webtrackerxy/MiniDroneGimbal/v1.2/top_pivot_section_v1.2.png

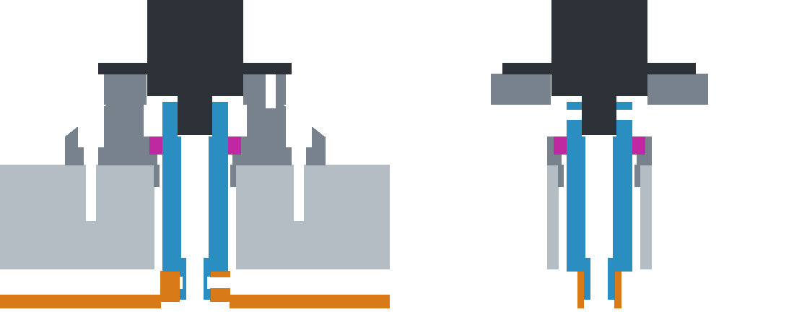
v1.2/top_pivot_section_v1.2.png
