webtrackerxy/MiniDroneGimbal/v1.2/BOM_v1.2.md

# Mini Drone Gimbal v1.2: bill of materials

Generated by `mini_drone_gimbal.py`. Print files are in `stl/` and `3mf/`.

## Printed parts

| File | Qty | Size, mm | Solid mass | Notes |
|---|---|---|---|---|
| upright_v1.2 | 2 | 232 × 24 × 24 | 326 g | Frame sides |
| top_bar_a_v1.2 | 1 | 203 × 24 × 24 | 121 g | Top bar, with the top pivot |
| top_bar_b_v1.2 | 1 | 119 × 24 × 24 | 70 g | Top bar |
| outer_ring_v1.2 | 1 | 226 × 215 × 10 | 30 g | Yaw ring |
| inner_ring_v1.2 | 1 | 220 × 188 × 10 | 27 g | Pitch ring |
| cradle_v1.2 | 1 | 52 × 182 × 28 | 14 g | Roll axis, holds the drone |
| sensor_mount_v1.2 | 1 | 28 × 49 × 13 | 6 g | Sensor board plate under the tray |
| cover_v1.2 | 1 | 46 × 60 × 18 | 5 g | Holds the drone body down |
| clip_v1.2 | 1 | 78 × 67 × 10 | 8 g | Snaps the cover on |
| bearing_fit_test_v1.2 | 1 | 51 × 8 × 10 | 1 g | Print first, to tune BEARING_D |
| pivot_shims_v1.2 | 1 | 53 × 4 × 1 | 0 g | 8 on one plate, 6 needed. Use a brim |
| slip_mount_v1.2 | 1 | 60 × 50 × 26 | 28 g | Holds the slip ring on the top bar |
| slip_tube_v1.2 | 1 | 15 × 15 × 46 | 7 g | Turns with the outer ring, carries the slip ring stem |
| base_a_v1.2 | 1 | 217 × 217 × 54 | 403 g | Base frame, corner section |
| base_b_v1.2 | 1 | 105 × 217 × 24 | 195 g | Base frame, corner section |
| base_c_v1.2 | 1 | 217 × 105 × 54 | 251 g | Base frame, corner section |
| base_d_v1.2 | 1 | 105 × 105 × 24 | 115 g | Base frame, corner section |

Total solid mass 1.61 kg. That is the upper limit: with 15% infill on the frame it prints much lighter. PLA or PETG, 0.2 mm layers, no supports.

## Hardware

| Part | Qty | Used for |
|---|---|---|
| MR63ZZ bearing, 3 × 6 × 2.5 mm | 5 | Two per pivot, none at the top pivot |
| M3 × 8 socket head screw | 8 | 5 pivot axles, 3 slip ring flange |
| M3 × 12 socket head screw | 4 | Uprights to base and top bar |
| M3 × 16 socket head screw | 4 | 2 sensor mount to tray, 2 slip mount to top bar |
| M3 × 20 socket head screw | 12 | Frame lap joints |
| M3 hex nut, 5.5 mm across flats | 19 | 5 pivots, 12 frame joints, 2 sensor mount |
| M3 × 5 socket head screw | 1 | Side screw, outer ring boss to slip tube |
| M3 × 6 set screw, or short M3 screw | 2 | Slip tube onto the slip ring stem |
| M3 washer, 7 mm OD | 3 | Under the slip ring flange screws |
| Slip ring, 12 wire, 22 mm body (SNM022A-12) | 1 | Top pivot, and power to the drone |
| 6702ZZ ball bearing, 15 × 21 × 4 mm | 1 | Steadies the slip tube inside slip_mount |
| M3 screw or 3 mm woodscrew, 30 mm or longer | 4 | Base to the bench |
| Soft foam pad, about 15 × 20 × 2–3 mm | 1 | Inside the crown of the cover |
