webtrackerxy/MiniDroneGimbal/v1.2/3mf/outer_ring_v1.2.3mf

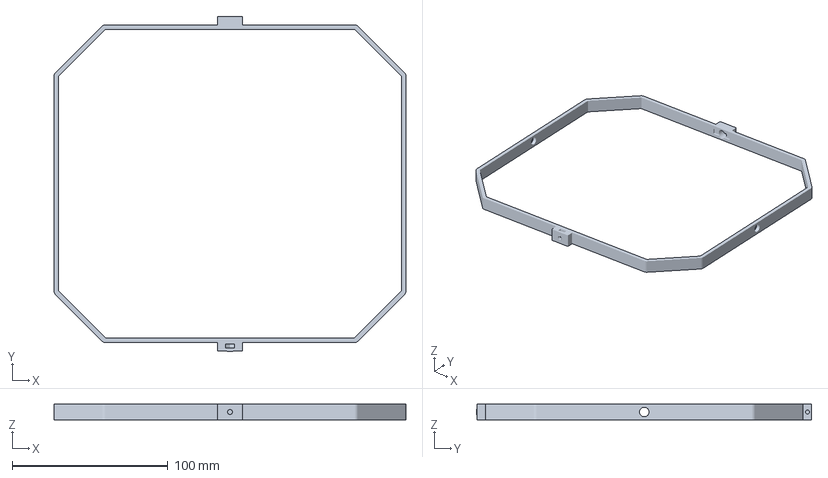
[picture p3: CAD file, 2026-11-06]
v1.2/3mf/outer_ring_v1.2.3mf
226.0 x 215.4 x 10.0 mm
