webtrackerxy/MiniDroneGimbal/v1.2/3mf/top_bar_b_v1.2.3mf

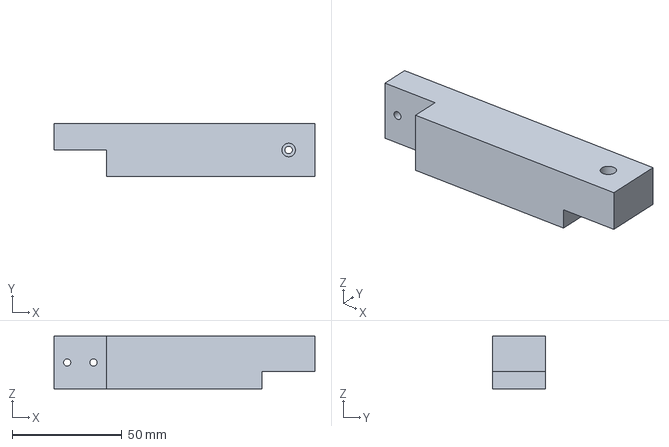
[picture p4: CAD file, 2026-11-06]
v1.2/3mf/top_bar_b_v1.2.3mf
119.0 x 24.0 x 24.0 mm
