webtrackerxy/MiniDroneGimbal/v1.2/3mf/base_c_v1.2.3mf

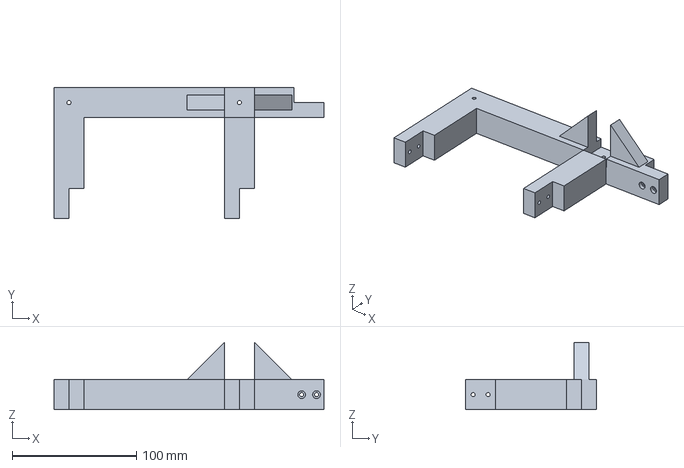
[picture p5: CAD file, 2026-11-06]
v1.2/3mf/base_c_v1.2.3mf
217.0 x 105.0 x 54.0 mm
