webtrackerxy/MiniDroneGimbal/v1.2/3mf/slip_tube_v1.2.3mf

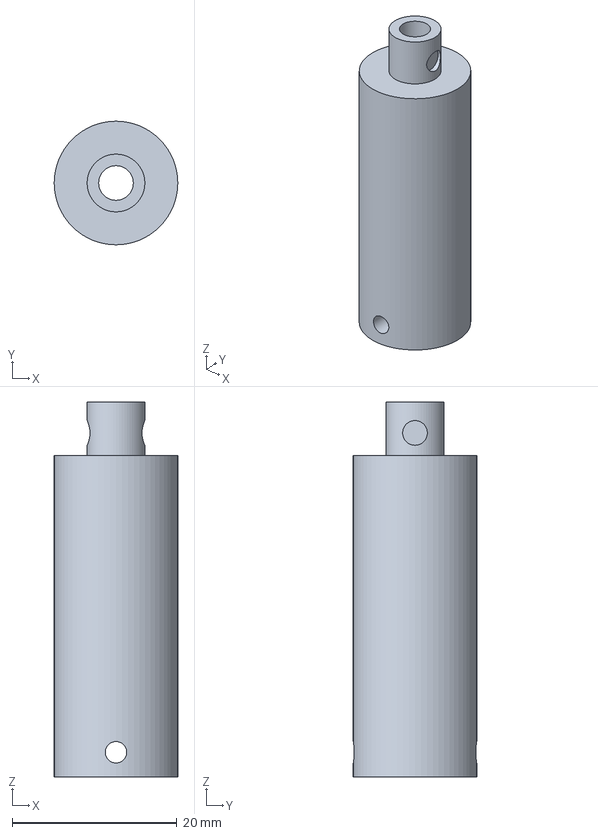
[picture p6: CAD file, 2026-11-06]
v1.2/3mf/slip_tube_v1.2.3mf
15.0 x 15.0 x 45.5 mm
