webtrackerxy/MiniDroneGimbal/v1.2/3mf/pivot_shims_v1.2.3mf

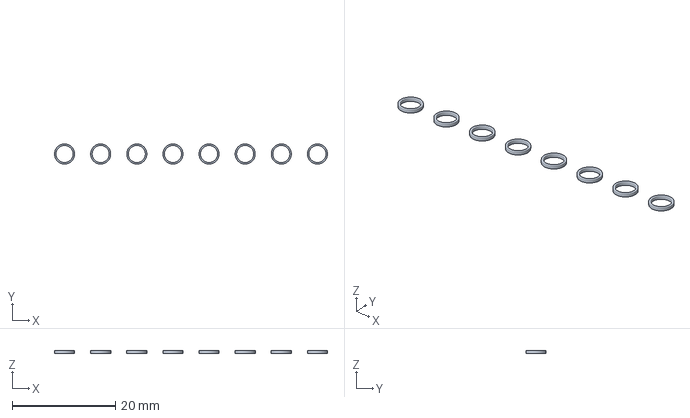
[picture p7: CAD file, 2026-11-06]
v1.2/3mf/pivot_shims_v1.2.3mf
52.9 x 3.90 x 0.6 mm
