webtrackerxy/MiniDroneGimbal/v1.2/3mf/slip_mount_v1.2.3mf

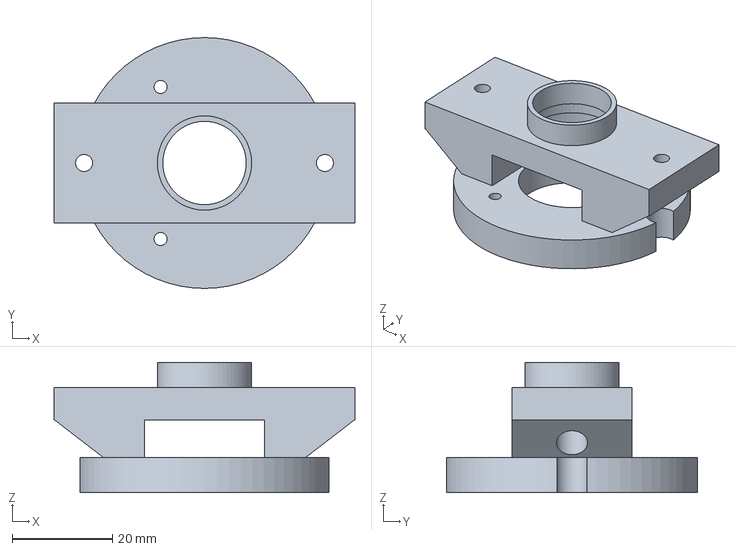
[picture p8: CAD file, 2026-11-06]
v1.2/3mf/slip_mount_v1.2.3mf
60.0 x 50.0 x 26.0 mm
