webtrackerxy/MiniDroneGimbal/v1.2/3mf/sensor_mount_v1.2.3mf

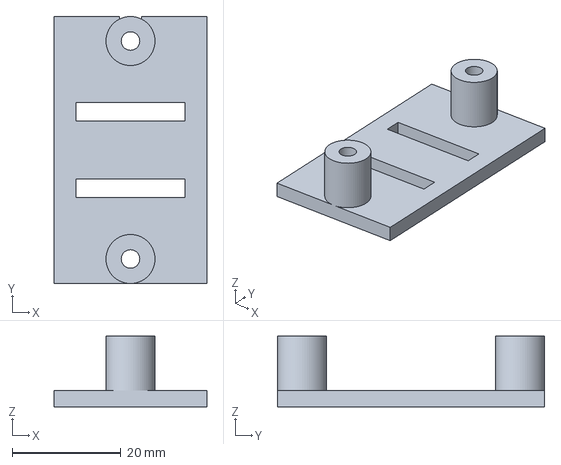
[picture p9: CAD file, 2026-11-06]
v1.2/3mf/sensor_mount_v1.2.3mf
28.0 x 49.0 x 13.0 mm
