webtrackerxy/MiniDroneGimbal/v1.2/3mf/cover_v1.2.3mf

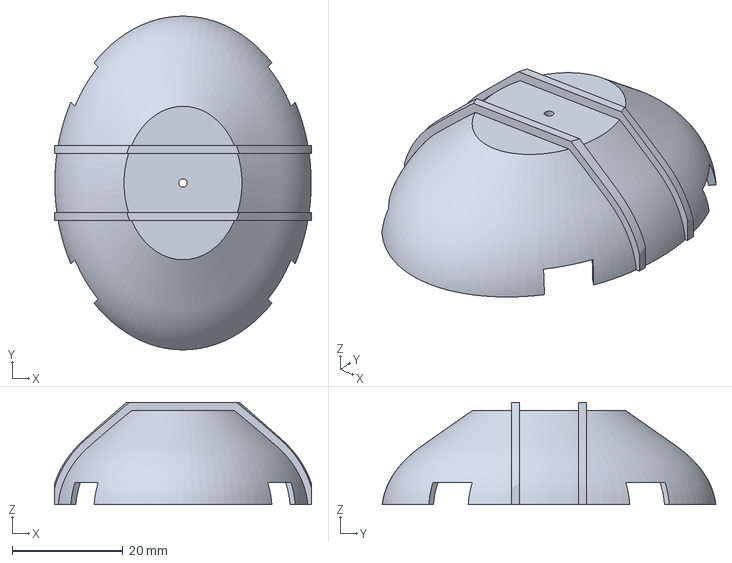
[picture p10: CAD file, 2026-11-06]
v1.2/3mf/cover_v1.2.3mf
46.4 x 60.3 x 18.5 mm
