webtrackerxy/MiniDroneGimbal/v1.2/3mf/cradle_v1.2.3mf

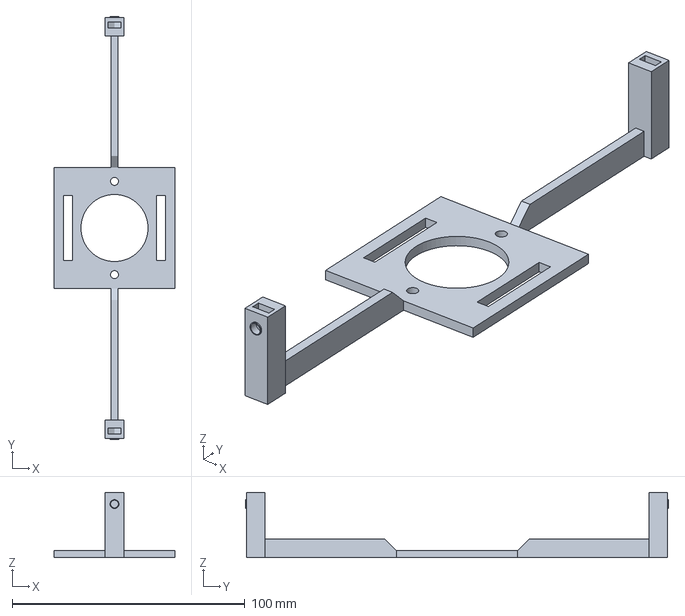
[picture p11: CAD file, 2026-11-06]
v1.2/3mf/cradle_v1.2.3mf
52.0 x 181.8 x 28.0 mm
