webtrackerxy/MiniDroneGimbal/v1.2/3mf/base_a_v1.2.3mf

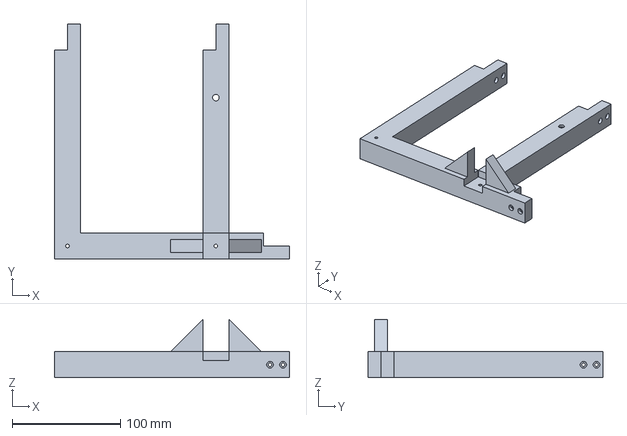
[picture p12: CAD file, 2026-11-06]
v1.2/3mf/base_a_v1.2.3mf
217.0 x 217.0 x 54.0 mm
