webtrackerxy/MiniDroneGimbal/v1.2/3mf/base_d_v1.2.3mf

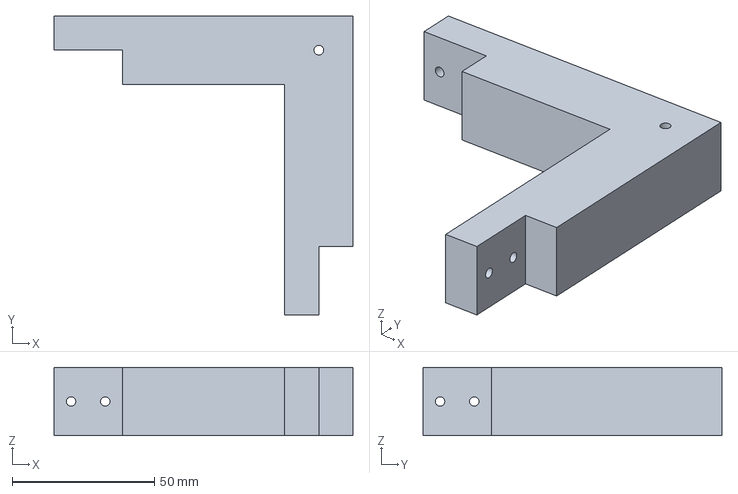
[picture p13: CAD file, 2026-11-06]
v1.2/3mf/base_d_v1.2.3mf
105.0 x 105.0 x 24.0 mm
