webtrackerxy/MiniDroneGimbal/v1.2/3mf/inner_ring_v1.2.3mf

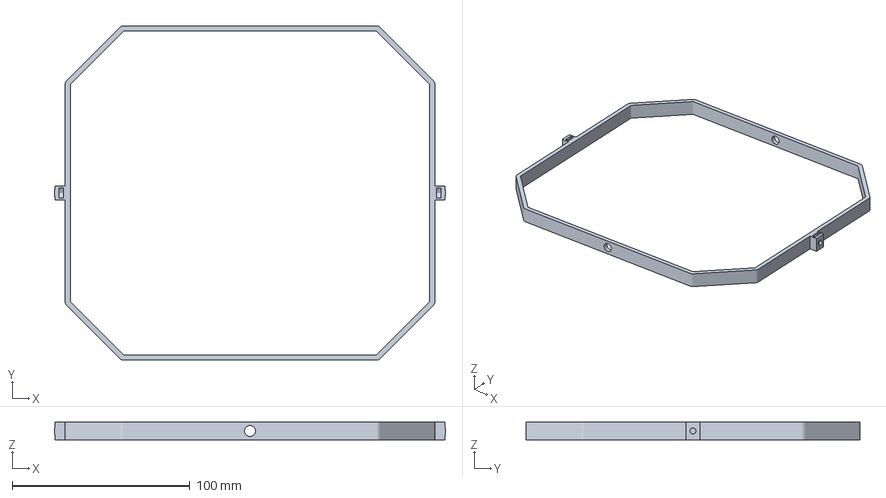
[picture p14: CAD file, 2026-11-06]
v1.2/3mf/inner_ring_v1.2.3mf
219.8 x 188.0 x 10.0 mm
