webtrackerxy/MiniDroneGimbal/v1.2/3mf/upright_v1.2.3mf

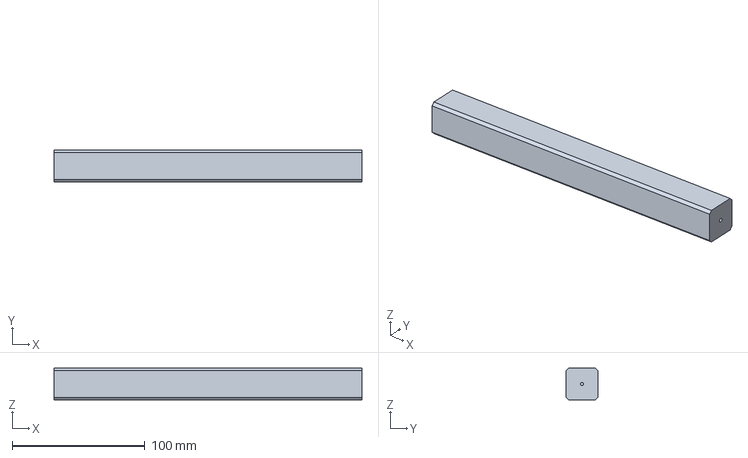
[picture p15: CAD file, 2026-11-06]
v1.2/3mf/upright_v1.2.3mf
232.0 x 24.0 x 24.0 mm
