webtrackerxy/MiniDroneGimbal/v1.2/3mf/top_bar_a_v1.2.3mf

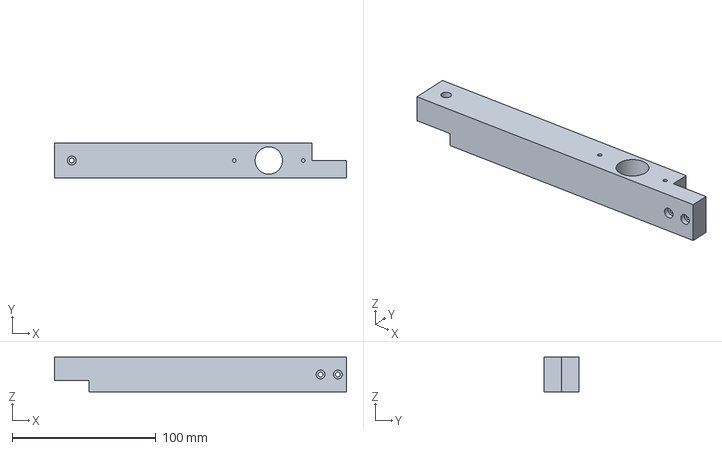
[picture p16: CAD file, 2026-11-06]
v1.2/3mf/top_bar_a_v1.2.3mf
203.0 x 24.0 x 24.0 mm
