webtrackerxy/MiniDroneGimbal/v1.2/3mf/clip_v1.2.3mf

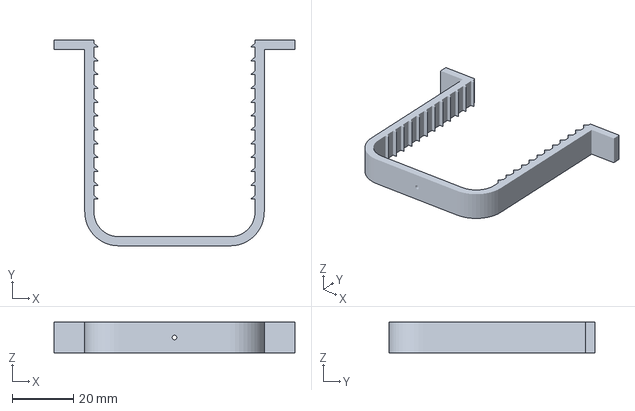
[picture p17: CAD file, 2026-11-06]
v1.2/3mf/clip_v1.2.3mf
78.4 x 66.9 x 10.0 mm
