webtrackerxy/MiniDroneGimbal/v1.2/3mf/bearing_fit_test_v1.2.3mf

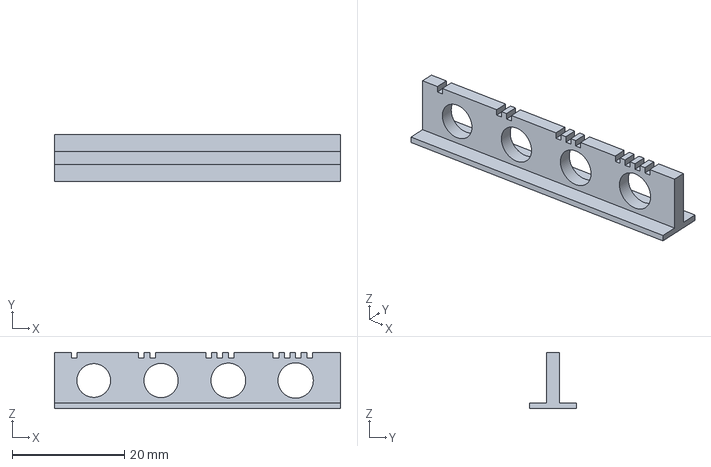
[picture p18: CAD file, 2026-11-06]
v1.2/3mf/bearing_fit_test_v1.2.3mf
51.0 x 8.30 x 10.0 mm
