webtrackerxy/MiniDroneGimbal/v1.2/3mf/base_b_v1.2.3mf

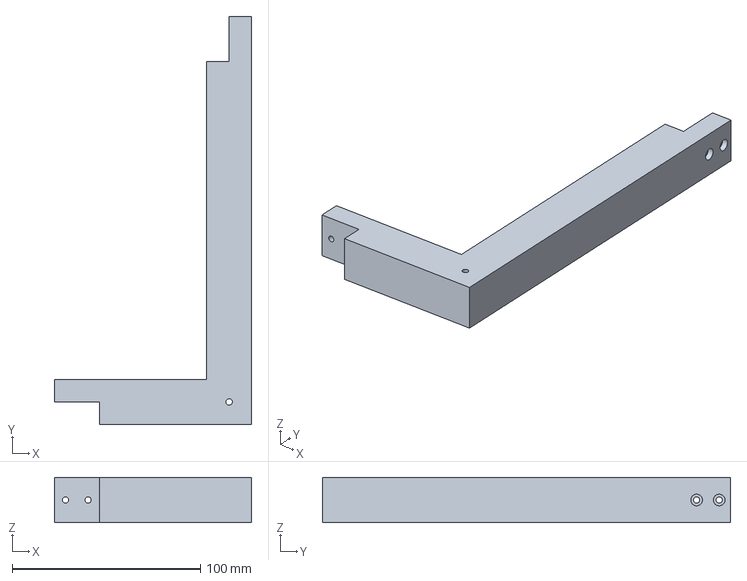
[picture p19: CAD file, 2026-11-06]
v1.2/3mf/base_b_v1.2.3mf
105.0 x 217.0 x 24.0 mm
