webtrackerxy/MiniDroneGimbal/(list of files, cad)

Other CAD files:
v1.0/3mf/inner_ring_v1.0.3mf
v1.0/3mf/base_a_v1.0.3mf
v1.0/3mf/base_b_v1.0.3mf
v1.0/3mf/base_c_v1.0.3mf
v1.0/3mf/base_d_v1.0.3mf
v1.0/3mf/bearing_fit_test_v1.0.3mf
v1.0/3mf/clip_v1.0.3mf
v1.0/3mf/cover_v1.0.3mf
v1.0/3mf/cradle_v1.0.3mf
v1.0/3mf/outer_ring_v1.0.3mf
v1.0/3mf/pivot_shims_v1.0.3mf
v1.0/3mf/sensor_mount_v1.0.3mf
v1.0/3mf/top_bar_a_v1.0.3mf
v1.0/3mf/top_bar_b_v1.0.3mf
v1.0/3mf/upright_v1.0.3mf
v1.0/stl/base_a_v1.0.stl
v1.0/stl/base_b_v1.0.stl
v1.0/stl/base_c_v1.0.stl
v1.0/stl/base_d_v1.0.stl
v1.0/stl/bearing_fit_test_v1.0.stl
v1.0/stl/clip_v1.0.stl
v1.0/stl/cover_v1.0.stl
v1.0/stl/cradle_v1.0.stl
v1.0/stl/inner_ring_v1.0.stl
v1.0/stl/outer_ring_v1.0.stl
v1.0/stl/pivot_shims_v1.0.stl
v1.0/stl/sensor_mount_v1.0.stl
v1.0/stl/top_bar_a_v1.0.stl
v1.0/stl/top_bar_b_v1.0.stl
v1.0/stl/upright_v1.0.stl
v1.1/3mf/base_a_v1.1.3mf
v1.1/3mf/base_b_v1.1.3mf
v1.1/3mf/base_c_v1.1.3mf
v1.1/3mf/base_d_v1.1.3mf
v1.1/3mf/bearing_fit_test_v1.1.3mf
v1.1/3mf/clip_v1.1.3mf
v1.1/3mf/cover_v1.1.3mf
v1.1/3mf/cradle_v1.1.3mf
v1.1/3mf/inner_ring_v1.1.3mf
v1.1/3mf/outer_ring_v1.1.3mf
v1.1/3mf/pivot_shims_v1.1.3mf
v1.1/3mf/sensor_mount_v1.1.3mf
v1.1/3mf/slip_mount_v1.1.3mf
v1.1/3mf/slip_tube_v1.1.3mf
v1.1/3mf/top_bar_a_v1.1.3mf
v1.1/3mf/top_bar_b_v1.1.3mf
v1.1/3mf/upright_v1.1.3mf
v1.1/stl/base_a_v1.1.stl
v1.1/stl/base_b_v1.1.stl
v1.1/stl/base_c_v1.1.stl
v1.1/stl/base_d_v1.1.stl
v1.1/stl/bearing_fit_test_v1.1.stl
v1.1/stl/clip_v1.1.stl
v1.1/stl/cover_v1.1.stl
v1.1/stl/cradle_v1.1.stl
v1.1/stl/inner_ring_v1.1.stl
v1.1/stl/outer_ring_v1.1.stl
v1.1/stl/pivot_shims_v1.1.stl
v1.1/stl/sensor_mount_v1.1.stl
v1.1/stl/slip_mount_v1.1.stl
v1.1/stl/slip_tube_v1.1.stl
v1.1/stl/top_bar_a_v1.1.stl
v1.1/stl/top_bar_b_v1.1.stl
v1.1/stl/upright_v1.1.stl
v1.2/stl/base_a_v1.2.stl
v1.2/stl/base_b_v1.2.stl
v1.2/stl/base_c_v1.2.stl
v1.2/stl/base_d_v1.2.stl
v1.2/stl/bearing_fit_test_v1.2.stl
v1.2/stl/clip_v1.2.stl
v1.2/stl/cover_v1.2.stl
v1.2/stl/cradle_v1.2.stl
v1.2/stl/inner_ring_v1.2.stl
v1.2/stl/outer_ring_v1.2.stl
v1.2/stl/pivot_shims_v1.2.stl
v1.2/stl/sensor_mount_v1.2.stl
v1.2/stl/slip_mount_v1.2.stl
v1.2/stl/slip_tube_v1.2.stl
v1.2/stl/top_bar_a_v1.2.stl
v1.2/stl/top_bar_b_v1.2.stl
v1.2/stl/upright_v1.2.stl
