webtrackerxy/MiniDroneGimbal/(commit log)

2026-11-06 Mini drone gimbal v1.0, v1.1 and v1.2
    A 3D-printable, three-axis test gimbal for a small quadcopter, generated from
    one Python script. Each v1.x/ folder holds every part as STL and 3MF, a bill
    of materials and a preview image.
    Source: release_to_main 2562c72
    [BOM_v1.0.csv, BOM_v1.1.csv, BOM_v1.2.csv, base_a_v1.0.3mf, base_a_v1.0.stl, base_a_v1.1.3mf, base_a_v1.1.stl, base_a_v1.2.3mf]
2026-11-06 Release: note the printer and material
    The README now says the parts were printed in PLA on a Bambu Lab A1.
    Source: release_to_main ecc4506
